matthewgream/12vdc_ups_18650_4s5p/README.md

# 12 VDC UPS — 18650 4S5P

A compact DC uninterruptible power supply that delivers a regulated **12 V** to network equipment (fibre CPE, router, Wi-Fi hub) from a 24 V mains adapter, with seamless switchover to a **4S5P 18650 lithium-ion pack** when mains fails.

It's built around an off-the-shelf DC UPS module that does the charging, power-path switching, buck-boost regulation and battery undervoltage cutoff. Around it sit a balancing BMS, per-output fusing, and a 3D-printed PETG housing and cell harness (OpenSCAD sources included).

> ⚠️ **Lithium-ion packs store a lot of energy (~250 Wh here) and can cause fires if built or used incorrectly.** This is a record of one build, not a certified product. Build at your own risk, and only if you are comfortable with spot-welding cells, pack wiring and DC fusing.

| Assembly | Plan |
|---|---|
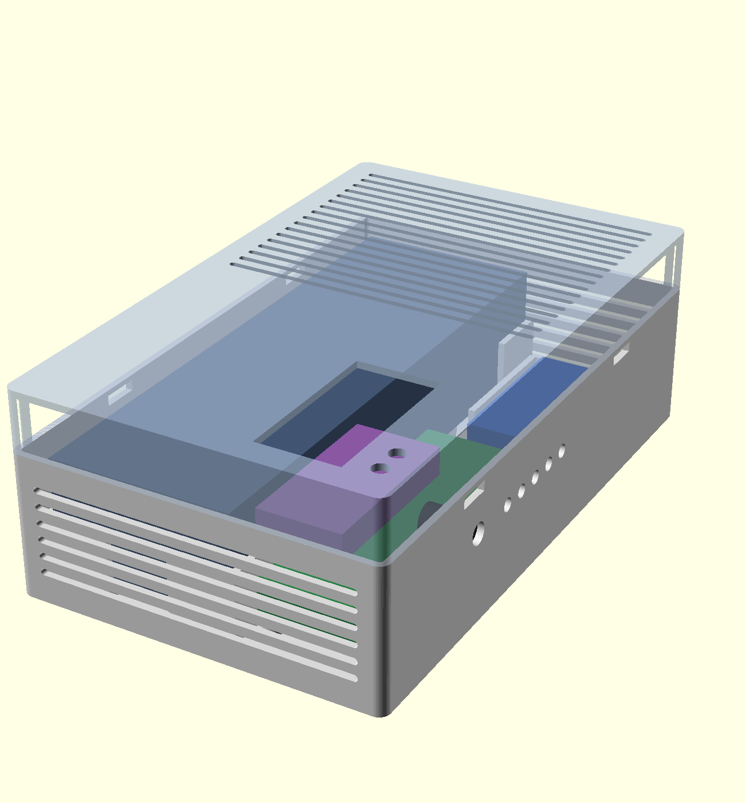
[picture p1: housing_ups_12vdc_assembly.png]
Assembly view
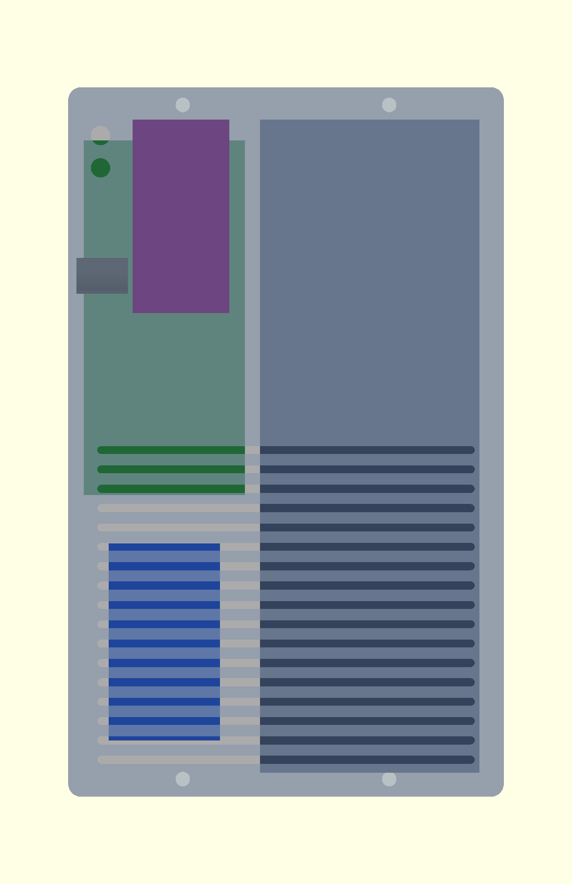
[picture p2: housing_ups_12vdc_plan.png]
Plan view
|  |  |

_Renders of the housing design. See [Build photos](#build-photos) for the real thing._

---

## Contents

- [Overview](#overview)
- [Specifications and operating limits](#specifications-and-operating-limits)
- [Runtime](#runtime)
- [Architecture](#architecture)
- [Bill of materials](#bill-of-materials)
- [Housing and harness (3D files)](#housing-and-harness-3d-files)
- [Build](#build)
- [Board configuration](#board-configuration)
- [Commissioning and testing](#commissioning-and-testing)
- [Operation and maintenance](#operation-and-maintenance)
- [Safety notes](#safety-notes)
- [Build photos](#build-photos)
- [Design rationale](#design-rationale)

---

## Overview

| | |
|---|---|
| Output | 12.0 V DC regulated, 5 individually fused outputs (2 A, 2 A, 3 A, 3 A, 5 A; 5.5 mm barrel) |
| Input | 24 V DC, 5 A (120 W) external adapter |
| Battery | 20 × 18650 Li-ion, 4S5P, ~14.5 V nominal, ~17.5 Ah, ~254 Wh |
| Switchover | Zero-time; output stays regulated across mains loss and return |
| Protection | Board UVP + output OCP/short protection, Daly 4S BMS (per-cell OV/UV/OC/short + balancing), fused battery, input and outputs |
| Intended load | ~20–30 W of network equipment (e.g. CTS HES-3106-PLUS, MikroTik PowerBox Pro, Sagemcom Wi-Fi Hub 2) |

### Why 4S?

A 3S Li-ion pack spans 9.0–12.6 V and sits at ~11.1 V for most of its discharge, which is below 12 V. 4S spans 12.0–16.8 V. The UPS module's buck-boost regulator could run from either, but 4S halves the battery current for a given load compared with 2S, cuts it by about a quarter compared with 3S, and keeps the converter working in step-down mode for nearly the whole discharge. That means lower losses and less heat.

---

## Specifications and operating limits

### UPS module (as supplied)

| Parameter | Limit |
|---|---|
| Input voltage | 10–28 V DC; must be ≥ 1 V above the charge voltage to charge |
| Input current | 15 A max (fuse-limited) |
| Output voltage | 2–28 V adjustable, **set to 12.0 V** |
| Output current | 8.3 A continuous (100 W), 10 A peak |
| Output regulation / ripple | ±2%, < 80 mV p-p |
| Charge voltage | 4–23 V adjustable |
| Charge current | 0.5–5 A adjustable; terminates at 1/10 of set current |
| Efficiency | > 95% (charging and output conversion) |
| Standby current | < 200 µA |
| Operating temperature | −45 to +85 °C (board) |

### System limits (this build)

These come from the weakest component in each path, not from the module alone.

| Parameter | Limit | Set by |
|---|---|---|
| Output, on battery | **≤ 100 W continuous** (8.3 A) | UPS module |
| Output, on mains, while charging | **≤ ~75 W continuous** | 24 V 5 A adapter (120 W) minus ~34 W charging |
| Output, on mains, battery full | **≤ 100 W** | UPS module (the 120 W adapter is no longer the limit) |
| Per-output current | Fuse rating: 2 / 2 / 3 / 3 / 5 A | Output fuses (F2–F6) |
| **Total output, all outputs combined** | **≤ 8.3 A continuous (100 W), 10 A peak** | UPS module. The output fuses add up to 15 A, so they are deliberately over-provisioned. Each fuse protects only its own branch, and the combined load must stay within the module rating (and within the adapter budget on mains). |
| Battery discharge current | ~8.5 A at 100 W out and 12.4 V cutoff (~1.7 A/cell) | Load; pack fuse 10 A, BMS 15 A, cells 10 A each |
| Battery charge current | **2.0 A** (~0.11C, 0.4 A/cell) | Setting (VR1) |
| Charge voltage (charge ceiling) | **16.2 V** (4.05 V/cell, ~85% SoC); selectable 16.0–16.8 V | Setting (VR2), see [Charge ceiling](#charge-ceiling-state-of-charge) |
| Undervoltage cutoff | **12.4 V** (3.10 V/cell) | Setting (VR4) |
| Restart threshold | **13.6 V** (3.40 V/cell) | Setting (VR3) |
| Cell charge temperature | 0–45 °C | Li-ion chemistry; **do not charge below 0 °C** |
| Cell discharge temperature | −20 to +60 °C | Li-ion chemistry |
| Enclosure ambient | Indoor, dry, ideally 10–30 °C | Housing material and cell life |

> **Note on the adapter:** the module doesn't appear to throttle charge current to protect the adapter. The **24 V 5 A (120 W)** adapter supports ~75 W of output while charging; for heavier loads, reduce the charge current or fit a larger adapter.

> **Note on "10 A":** the module's continuous rating is **8.3 A at 12 V**, with 10 A as a peak. Size loads accordingly.

---

## Runtime

At the default 85% charge ceiling, usable energy is about **195 Wh** at the output. That's 254 Wh nominal, less ~15% unused at the top, a few percent below the 3.10 V/cell cutoff, and ~5% conversion loss. For other ceilings see [Charge ceiling](#charge-ceiling-state-of-charge).

| Load | Approx. runtime (85% ceiling) |
|---|---|
| 10 W | ~19 h |
| 20 W | ~10 h |
| 25 W | ~8 h |
| 30 W | ~6.5 h |
| 50 W | ~4 h |
| 100 W | ~2 h |

Real-world draw of network gear is usually well below adapter ratings. Measure yours with an inline DC meter.

---

## Architecture

```
 230 VAC ──► 24 V 5 A PSU ──► panel jack ──► [F1 7.5 A, inline] ──► UPS VIN+ / GND
                                                           │
                                                    ┌──────┴───────┐
                                                    │  UPS module  │  charge (CC/CV, buck)
                                                    │              │  power path (zero-time)
  4S5P pack ─► [F0 10 A, inline] ─► Anderson ─► BAT │              │  buck-boost 12.0 V out
     │                          ▲                   │              │  UVP / restart
     └─ Daly 4S BMS (B-/P-, balance leads)          └──────┬───────┘
                                                           │ VOUT 12 V / GND
                                                           ▼
            VOUT+ ─► 5.08 mm edge conn (+, fan-out) ─┬─► [F2 2 A] ─► OUT1
                                                     ├─► [F3 2 A] ─► OUT2
                                                     ├─► [F4 3 A] ─► OUT3
                                                     ├─► [F5 3 A] ─► OUT4
                                                     └─► [F6 5 A] ─► OUT5
            GND ───► 5.08 mm edge conn (−, fan-out) ───────────────► OUT1…OUT5 sleeves

            All fuses F0–F6 are inline blade holders inside the housing.
```

- **F0 (pack fuse)** is an inline holder inside the housing, on the pack positive between the BMS/pack side and the Anderson connector. Keeping it on the pack side means it protects the Anderson, the leads to the board and the board's battery input from a pack-fed short. The only unprotected conductor is the short lead from the pack to F0, so keep it as short as practical and well secured.
- The **BMS** switches the pack negative (B- to cells, P- to the Anderson). It is a **common-port** type: charge and discharge share P-.
- The **Anderson connector** is the battery service disconnect. Open it whenever you adjust charge voltage or work on the board.
- **Inline fusing throughout:** every fuse (F0 pack, F1 input, F2–F6 outputs) is an inline blade holder inside the housing. That's neater and more compact than a fuse block, and no routine user servicing is expected. Separate holders also mean the 24 V input and the 12 V outputs can never share a bus.
- **Outputs are a menu, not a budget:** the five outputs are fused 2 / 2 / 3 / 3 / 5 A so each device can be plugged into a suitably rated output. The fuses total 15 A, which is more than the module's 8.3 A. The combined load is limited by the module and the adapter, not by the fuses (see [System limits](#system-limits-this-build)).

---

## Bill of materials

Prices are as purchased (GBP, late 2026) and are indicative only. Choose 5.5/2.1mm or 5.5/2.5mm barrel fittings as appropriate. I purchased an equal set of both, and the 24 V power supply turned out to have 2.1mm male, so the 2.1mm variant of the panel connector was installed. Other options are to dual 5.5/2.1+2.5 on each output, or to select 2.1 or 2.5 but arm with 2.1->2.5 or 2.5->2.1 adapters.

| Qty | Item | Price (ea.) | Notes | Link |
|---|---|---|---|---|
| 1 | DC power supply 24 V 5 A, 5.5/2.x barrel | £13.94 | Mains input. Must be ≥ 1 V above the charge voltage (≥ 17.8 V covers every ceiling up to 16.8 V). 5 A (120 W) covers ~75 W of load while charging. | [AliExpress](https://www.aliexpress.com/item/1005007332397741.html) |
| 1 | DC UPS power module, 12 V out, 15 A max input | £36.79 | Main board: charger, power path, buck-boost regulator, UVP, LEDs | [AliExpress](https://www.aliexpress.com/item/1005001636977344.html) |
| 1 | Daly 4S 15 A BMS, 3.7 V Li-ion, common port, with balancing | £7.15 | Per-cell protection and passive balancing | [AliExpress](https://www.aliexpress.com/item/1005005995685641.html) |
| 1 | Inline blade fuse holder, 16 AWG, 10 A (2-pack) | — | Used for F0 (pack, 10 A fuse) and one output. With the 5-pack below this gives 7 holders: 6 × 16 AWG (F0, F2–F6) and 1 × 12 AWG (F1). | [Amazon](https://www.amazon.co.uk/dp/B0HG927H6S) |
| 1 | Inline blade fuse holder set (5 pcs): 1 × 12 AWG 15–30 A, 4 × 16 AWG 10 A | — | 12 AWG holder for F1 (24 V input, 7.5 A fuse). 4 × 16 AWG holders for outputs. | [Amazon](https://www.amazon.co.uk/dp/B0DBPQBGBQ) |
| n | DC blade fuses 2/3/5/7.5/10 A | £0.93 | F0 10 A, F1 7.5 A, F2–F6 2/2/3/3/5 A. Name-brand with 1000 A DC interrupt rating recommended for F0. | [AliExpress](https://www.aliexpress.com/item/4000832079230.html) |
| 1 | DC 5.5/2.x barrel panel connector, 10 A, 15 cm | £1.37 | Mains adapter input jack | [AliExpress](https://www.aliexpress.com/item/1005007189485497.html) |
| 5 | DC 5.5/2.x power leads, 18 AWG, 1.5 m | £3.26 | One per output. Match inner diameter (2.1 or 2.5 mm) to each device. 18 AWG is good to ~7 A. | [AliExpress](https://www.aliexpress.com/item/1005012145395888.html) |
| 1 | DC voltage level display (panel meter) | £4.69 | Front-panel battery voltage readout; fits the 60 × 30 mm window in the cover. Its measuring and supply range must cover the pack (12–16.8 V). See [Wiring](#6-wiring) for where to connect it. | [AliExpress](https://www.aliexpress.com/item/1005006408211879.html) |
| 2 | 6 mm LED indicator, panel mount, 3–6 V | £0.78 | Front-panel status LEDs via J8 (e.g. input power, charging/fault), mounted in the cover beside the meter. 5-pack (£3.89). | [AliExpress](https://www.aliexpress.com/item/1005005391948256.html) |
| 20 | LG MJ1 18650, 3500 mAh, 10 A | £2.81 | 4S5P, welded in a 10 × 2 honeycomb array | [Cell Supply](https://www.cellsupply.co.uk/lg-mj1-18650-battery) |
| 1 | 2-core 18 AWG silicone tinned copper wire | £1.60 | Internal hookup | [AliExpress](https://www.aliexpress.com/item/1005012526819544.html) |
| 1 | Anderson 30 A connector | £2.51 | Pack-to-board connection and safety disconnect | [AliExpress](https://www.aliexpress.com/item/1005006226687227.html) |
| 2 | 5-pin pluggable edge connector, 5.08 mm, 15 A | £0.88 | 1 × UPS VOUT− fan-out to 5 outputs; 1 × UPS VOUT+ fan-out to the 5 output fuses | [AliExpress](https://www.aliexpress.com/item/1005009224192771.html) |
| 1 | 3-pin 2.54 mm JST connector, PCB + lead | — | Detachable LED harness | — |
| — | Nickel strip, 10 mm × 0.15 mm | — | Cell interconnects and wire tabs | — |
| — | Spot welder | — | — | — |
| 20 | Fish-paper insulator rings, 18650 | — | One per cell positive terminal | — |
| — | Heat-resistant insulating tape, packaging | — | Pack wrap | — |
| 4 | M4 self-tapping screws | — | UPS module to base | — |
| 4 | M4 self-tapping screws | — | Wall mounting | — |
| 1 | 3D-printed housing (base + cover), PETG | — | See below | — |
| 1 + 2 | 3D-printed cell harness: 1 footer + 2 spacers, PETG | — | See below | — |

**Approximate total:** ~£150 plus fuse holders (parts listed with prices, excluding printing, tools and consumables).

---

## Housing and harness (3D files)

| File | Description |
|---|---|
| `housing_ups_12vdc.3mf` | Print project for the enclosure and harness (Bambu Studio) |
| `housing_ups_12vdc.scad` | (Source) Parametric OpenSCAD source for the enclosure |
| `housing_ups_12vdc_base.stl` | (Generated) Enclosure base: UPS module, BMS, battery pack, wiring  |
| `housing_ups_12vdc_cover.stl` | (Generated) Enclosure cover |
| `housing_ups_12vdc_assembly.png` | (Generated) Assembly render |
| `housing_ups_12vdc_plan.png` | (Generated) Top-down plan render |
| `harness_cell_pack_18650.scad` | (Source) Parametric OpenSCAD source for the harness |
| `harness_cell_pack_18650_footer.stl` | (Generated) Cell footer: welding jig |
| `harness_cell_pack_18650_spacer.stl` | (Generated) Cell spacer: structural |
| `Makefile` | Build targets for the generated files |
| `images/` | Build photos |

**Cell harness.** The honeycomb cells don't butt against each other, so the welded nickel shouldn't be the only thing holding the pack in shape.
- **Footer:** the cells stand in it during welding, which holds them square and level so the strips sit flat across all ends.
- **Spacers (×2):** slid over the cells, one about 10 mm from the top and one about 10 mm from the bottom. They fix cell spacing and make the pack rigid independently of the welds, so handling and mounting loads aren't taken through the weld nuggets.

**Material:** all parts are printed in **PETG**. PLA softens at ~55–60 °C, and the enclosure sits next to a pack and a converter for years. No common printed plastic is fire-rated. Consider where the unit is mounted (see [Safety notes](#safety-notes)).

---

## Build

### 1. Cells
- Buy all cells from a reputable supplier in one batch. Counterfeit cells are common.
- Check each cell's voltage on arrival. Group cells so each parallel group is within **~0.05 V**, and preferably match groups by capacity.
- Fit fish-paper insulator rings on positive terminals. The positive cap and the can (negative) are millimetres apart.

### 2. Pack (4S5P)
- Stand the 20 cells in the **footer** as a 10 × 2 honeycomb, forming four parallel groups of five, and fit the two **spacers** (~10 mm from each end).
- Spot-weld 0.15 mm nickel. Don't solder directly to cells.
- Main leads: crimp 18 AWG to nickel tabs, then weld the tabs to the pack ends.
- Balance leads: weld to B0 (pack −), B1, B2, B3 and B4 (pack +). **Before covering,** measure B0→B1, B1→B2 and so on in sequence. Each step must read one group's voltage (~3.6–3.7 V as received), and B0→B4 the full pack voltage.
- Strain-relieve all leads so they can't flex at the weld.
- Wrap in heat-resistant tape, leaving the balance connector, F0 holder and Anderson connector outside the wrap and accessible.

### 3. BMS (Daly 4S, common port)
- Cells' negative → **B-**. BMS **P-** → Anderson negative.
- Follow Daly's connection order: B- first, then check balance lead voltages with a multimeter, then plug in the balance connector last. Wrong balance lead order is the most common way to destroy a BMS.
- Some Daly boards hold P- off until a charger voltage is applied. If you read 0 V at P-, connect the 24 V adapter once to wake it.

### 4. Pack fuse and disconnect
- **F0: 10 A blade fuse** in an inline holder mounted inside the housing, wired from the pack positive to the Anderson positive. The fuse is on the pack side of the disconnect, so it protects the Anderson and everything downstream.
- Keep the pack → F0 lead short and secured. It's the only conductor upstream of the fuse.
- Use a name-brand DC blade fuse. Voltage rating ≥ 24 V DC (pack max is 16.8 V), and interrupt rating ~1000 A DC.

### 5. Fusing
All fuses are inline blade holders inside the housing.

| Fuse | Circuit | Fuse rating | Holder |
|---|---|---|---|
| F0 | Pack positive → Anderson | 10 A | 16 AWG, 10 A |
| F1 | 24 V input: panel jack → UPS Vin+ | 7.5 A (suits the 5 A adapter) | 12 AWG, 15–30 A |
| F2 | OUT1 | 2 A | 16 AWG, 10 A |
| F3 | OUT2 | 2 A | 16 AWG, 10 A |
| F4 | OUT3 | 3 A | 16 AWG, 10 A |
| F5 | OUT4 | 3 A | 16 AWG, 10 A |
| F6 | OUT5 | 5 A | 16 AWG, 10 A |

The outputs are a choice of ratings: plug each device into an output whose fuse is roughly 1.5–2× its normal draw and no more than its original adapter rating. The output fuses total 15 A, but **the combined load must stay within 8.3 A continuous** (the module limit), and within ~75 W on mains while charging (the adapter limit). Keep peak loads in mind when adding devices.

Example allocation (this installation):

| Output | Fuse | Device |
|---|---|---|
| OUT1 | 2 A | CTS HES-3106-PLUS (12 V 1.5 A adapter) |
| OUT2 | 2 A | Spare |
| OUT3 | 3 A | Sagemcom Wi-Fi Hub 2 |
| OUT4 | 3 A | MikroTik PowerBox Pro |
| OUT5 | 5 A | Spare |

> **MikroTik PowerBox PoE-out:** the PowerBox's PoE-out ports (ether2–5) pass through whatever voltage the PowerBox is running from. In this installation one PoE-out port feeds an annex Wi-Fi AP. That AP is non-essential and is **not budgeted on the UPS**; it's allowed to drop during an outage, because the primary AP (Sagemcom) stays up. Check what actually happens to it when the PowerBox runs from the UPS's 12 V. An AP that accepts 12 V passive PoE would keep running and draw from the UPS (and through the 3 A fuse). One that needs 24 V+ will drop out or reboot-loop. If it does keep running, either budget for it or disable PoE-out on that port during outages (e.g. a RouterOS script on the PowerBox's voltage monitor).

### 6. Wiring
- 18 AWG silicone for internal hookup. The fuse holders' own 16 / 12 AWG pigtails are fine to join to it. Battery-side current is ≤ ~3 A normally and ≤ ~8.5 A worst case.
- Adapter jack → F1 → UPS **Vin+**. Jack negative → UPS input **GND**.
- UPS **VOUT+** → positive edge connector (fan-out) → F2–F6 → barrel centre pins.
- UPS output **GND** → negative edge connector (fan-out) → barrel sleeves.
- Pack (via F0 and Anderson) → UPS **BAT** terminals (J1).
- LEDs → J8 via the 3-pin JST lead (J8 carries LED1–LED3).
- Panel meter → UPS **BAT** terminals (J1), i.e. downstream of F0 and the Anderson, so its leads are fused and opening the Anderson disconnects it. Use a 2-wire meter there, or for a 3-wire meter take both its supply and its sense lead from BAT.
- **The meter is a permanent load on the pack** (typically 5–20 mA), including after the module's undervoltage cutoff has turned the output off. On a very long outage it keeps discharging the pack below 12.4 V until the BMS's own undervoltage trip disconnects it. That's safe, because the BMS is the backstop, but the pack then needs mains back to wake the BMS. If you'd rather avoid this, take the meter's supply from the 12 V output instead, so it switches off with the UVP, and keep only its sense lead on BAT (3-wire meters only).

### 7. Jumpers
- **J5 closed** (start switch) and **J7 shorted** (auto-start). Together these make the module start automatically whenever input power returns or the battery recovers above VSTART. Unattended operation needs this.
- **J6** left unset (mode 0). It's only used when the load is a PC motherboard.

---

## Board configuration

| Setting | Target | Adjust | How |
|---|---|---|---|
| Charge voltage | **16.2 V** (4.05 V/cell, ~85%); see table below | VR2 | **Battery disconnected.** Measure at the BAT terminals. The output pulses while detecting a battery; set the *peak* to the target. Counterclockwise raises. |
| Charge current | **2.0 A** | VR1 | Battery connected and partly discharged, ammeter in series with BAT+. Counterclockwise raises. |
| Undervoltage cutoff (VUVP) | **12.4 V** | VR4 | VUVP = 4 × V(TP4) → TP4 = **3.10 V** |
| Restart threshold (VSTART) | **13.6 V** | VR3 | VSTART = 4 × V(TP3) → TP3 = **3.40 V** |
| Output voltage | **12.0 V** | VR5 | J5 closed, no loads connected, measure at output |

Factory defaults are for 3S (12.6 V charge, 1 A, 9.0 V UVP, 9.6 V start, 12 V output). **Never connect a 4S pack before raising the charge voltage**, or it will charge incorrectly. And never adjust the charge voltage with any battery connected.

### Charge ceiling (state of charge)

A UPS pack spends almost all its life sitting at its charge ceiling, so **calendar ageing at high state of charge, not cycling, is what wears it out.** Lowering the ceiling is the single most effective way to extend pack life. The module terminates charging at C/10 and does not float, so the pack charges to the ceiling and then rests there.

| Ceiling (approx. SoC) | Per cell | Pack (set VR2) | Usable at output | Runtime @ 25 W | Longevity |
|---|---|---|---|---|---|
| 100% | 4.20 V | 16.8 V | ~230 Wh | ~9 h | Shortest. Only for a periodic top-balance. |
| 95% | 4.15 V | 16.6 V | ~220 Wh | ~8.5 h | Modest gain |
| 90% | 4.10 V | 16.4 V | ~205 Wh | ~8 h | Good |
| **85% (default)** | **4.05 V** | **16.2 V** | **~195 Wh** | **~8 h** | **Very good** |
| 80% | 4.00 V | 16.0 V | ~180 Wh | ~7 h | Best of these |

SoC figures are approximate for LG MJ1. They depend on chemistry, temperature and where termination occurs, so treat them as ±5%.

**Recommendation: 80–90%, default 85%.** This matches common practice in consumer devices: phones and laptops typically offer an 80–85% "battery protection" limit for devices left on charge. Below ~80% you give up runtime for diminishing longevity gain. Pick the lowest ceiling that still gives the runtime you need.

> **Balancing at reduced ceilings:** passive balancers on many BMS boards only bleed cells near the top of charge. Check the balance start voltage on your Daly BMS (label or listing). If it's above your ceiling, the BMS will never balance. Check group voltages every 6–12 months. If they've drifted by more than ~0.03 V, do one top-balance: disconnect the battery, set VR2 to 16.8 V, reconnect, let it charge and rest a day, then set it back. Alternatively, balance with a hobby charger on the balance lead.

### Why these values
- **Charge ceiling 16.2 V (85%):** see above. Longevity is the priority for an always-on UPS.
- **2.0 A:** gentle (0.4 A per cell, ~0.11C). Recharge time isn't critical. A full recharge from cutoff takes ~8–9 h, and total adapter load stays well within 120 W.
- **12.4 V cutoff:** well above the BMS's own over-discharge trip, so the BMS is a backstop rather than the normal cutoff. Also little capacity is left below ~3.1 V/cell under load.
- **13.6 V restart:** enough hysteresis that a rested pack recovering after cutoff doesn't make the output cycle on and off.

---

## Commissioning and testing

1. **Pre-power checks:** pack, BMS and balance leads verified (Build steps 2–3). Confirm with a continuity tester that there's no path from the 24 V input (jack, F1, Vin+) to the 12 V outputs, and that each output's fuse is in its positive lead. Anderson open. No loads connected.
2. **Adapter only:** connect the 24 V adapter. LED1 (blue, input) lights.
3. **Set the charge voltage** (VR2) to the chosen ceiling (default 16.2 V) as the peak at the BAT terminals.
4. **Set the thresholds:** TP4 = 3.10 V (VR4), TP3 = 3.40 V (VR3).
5. **Set the output:** J5 closed, J7 shorted. Set VOUT to 12.0 V (VR5). LED4 (output) lights.
6. **Connect the battery:** close the Anderson. Wake the BMS if needed. Charging starts; LED3 (green) lights.
7. **Set the charge current** (VR1) to 2.0 A with an ammeter in series. Do this with the pack partly discharged, or the reading won't be accurate.
8. **Switchover test:** connect a dummy or real load. Pull the adapter. VOUT must stay at 12.0 V with no reset of connected equipment. Restore the adapter and confirm charging resumes.
9. **Full charge:** confirm termination (LED3 off, LED2 red on) at the ceiling voltage, with current tapering to ~0.2 A.
10. **Recharge behaviour:** after termination, run briefly on battery (pull the adapter for a few minutes under load), then restore it. Confirm charging restarts. The manual doesn't document the recharge threshold, so verify the pack is topped up after short outages and not only after long ones.
11. **Runtime / UVP test (recommended once):** run on battery under normal load until cutoff. Confirm the output switches off near 12.4 V pack voltage and the BMS has *not* tripped. Restore mains and confirm auto-restart and recharge.
12. **Balance check:** after a full charge, measure each group. They should be within ~0.02 V.

---

## Operation and maintenance

- **Panel meter:** shows pack voltage. Use the [charge ceiling table](#charge-ceiling-state-of-charge) for full (16.0–16.8 V depending on setting) and 12.4 V for empty (UVP cutoff). Readings while charging or under load are a few tenths of a volt off the resting value.
- **Indicators:** LED1 blue = input present. LED3 green = charging; flashes when the battery is below VSTART, or flashes twice when it's below VUVP at start-up. LED2 red = charge complete. LED4 red = output on.
- **After an outage,** the module recharges automatically. A full recharge from cutoff takes ~8–9 h at 2.0 A.
- **Every 6–12 months:**
  - Check group balance (pack within ~0.02 V). Top-balance if needed (see [Charge ceiling](#charge-ceiling-state-of-charge)).
  - Check the enclosure for heat discolouration and the connectors for looseness.
  - Do a short discharge test to confirm runtime hasn't fallen significantly.
- **Storage:** if the unit will be unpowered for weeks, store the pack at ~3.7–3.8 V/cell (~15 V) and open the Anderson to remove BMS and board standby drain.
- **Retirement:** replace the pack if runtime drops below ~70% of new, or if any group drifts persistently out of balance.

---

## Safety notes

- **Fusing:** every source is fused: pack (F0, 10 A, inline), adapter input (F1, 7.5 A, inline), each output (F2–F6, 2/2/3/3/5 A), all inline inside the housing. The pack fuse is the critical one. A 254 Wh pack can source hundreds of amps into a short.
- **Disconnect** the battery (Anderson) before any work on the board, wiring or settings.
- **Never charge below 0 °C.** Lithium plating causes permanent damage and internal shorts. Don't install in unheated outbuildings or lofts without accounting for this.
- **Location:** mount on a non-combustible surface, away from soft furnishings, with airflow around the enclosure. A printed enclosure provides no fire containment.
- **Cell abuse:** don't mix cells of different type, age or state of charge. Discard any cell that is dented, has torn wrap, or self-discharges noticeably.
- **Polarity:** the module isn't documented as reverse-polarity protected on the battery input. Check polarity before closing the Anderson.

---

## Build photos

### Initial bench test - battery/mains supply/charge cycles

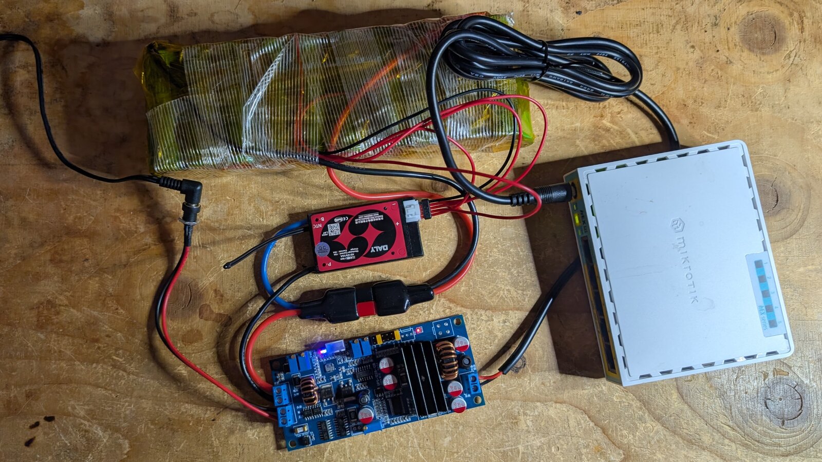
[picture p3: images/housing_ups_12vdc_bench_test_1.jpg]
Bench test of the UPS module, pack and wiring before assembly


_Bench test before assembly._ Tests run:
- Configure all parameters and check voltages and currents.
- Output stays up on the 24 V adapter and when the adapter is unplugged (battery).
- Discharge on battery past the restart threshold, then restore the adapter and monitor charging through to termination. Measure the charged pack voltage.
- Repeat with the pack drained down to the undervoltage cutoff.

### Assembly bench test

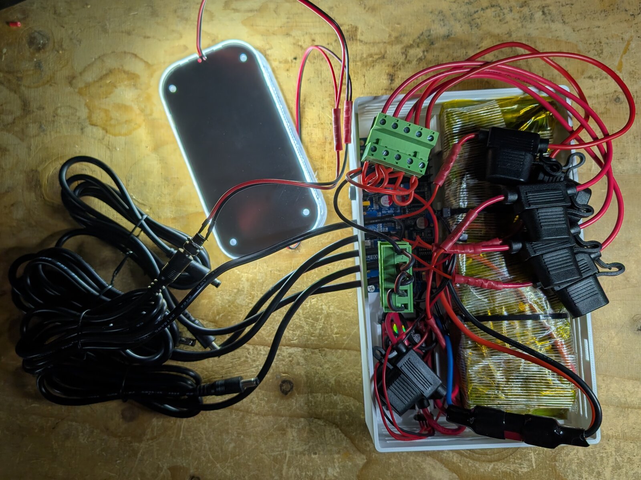
[picture p4: images/housing_ups_12vdc_bench_test_2.jpg]
Bench test of the UPS module, pack and wiring during assembly


_Bench test during assembly._ Tests run:
- Verify power and polarity on all wiring paths.
- Check assembly fitting (identified that the choice of inline fuse holders requires bulking out the cover).

### Built

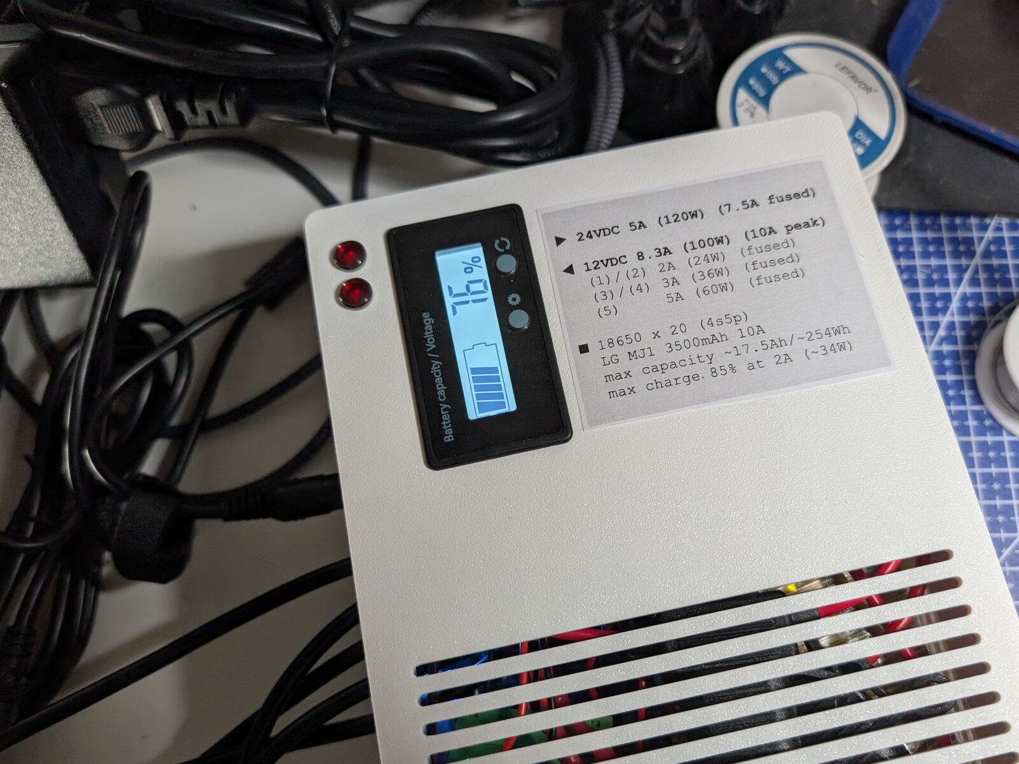
[picture p5: images/housing_ups_12vdc_built.jpg]
Built version, with battery monitor installed


_Build complete, with <a href="https://docs.google.com/document/d/1GiLOf5nCyJNSllKJYwVlJ6xkPohoDqQ-DGhpVirwHKc/view">label</a>_

---

## Design rationale

- **Integrated UPS module vs separate charger + buck:** an earlier candidate module (UPS-0528-11) passes the input voltage straight through to the output on mains (24 V) and outputs unregulated battery voltage on outage. It would have needed a separate wide-input buck converter and a low-voltage disconnect. The chosen module integrates a 100 W buck-boost regulator and adjustable UVP with restart hysteresis.
- **4S over 3S:** lower battery current and a near-continuous buck-mode regulator. 3S would also work with the module's factory settings at this load.
- **5P:** ~8 h runtime for ~25 W of network equipment, with each cell working at < 0.5 A typical.
- **Separate BMS:** the module only monitors total pack voltage. The Daly BMS adds per-cell over- and undervoltage protection, short-circuit protection and balancing.
- **Reduced charge ceiling and current:** an always-on UPS is limited by calendar ageing at high state of charge, and recharge time is rarely critical. So both are set for longevity rather than maximum runtime or fast recharge.
- **24 V adapter:** gives the 1 V headroom the step-down charger needs above any charge ceiling up to 16.8 V. A 19 V adapter would also work and slightly reduce charger conversion loss, but 24 V 5 A units are more common.

---

## Licence

See [`LICENSE`](LICENSE).
