matthewgream/12vdc_ups_18650_4s5p/label.pdf

- 24VDC 5A (120W) (7.5A fused)

◀ 12VDC 8.3A (100W) (10A peak) ◀ (1)/(2) 2A (24W) (fused)
◀ (3)/(4) 3A (36W) (fused)
◀ (5) 5A (60W) (fused)

■ 18650 x 20 (4s5p)
■ LG MJ1 3500mAh 10A
■ max capacity ~17.5Ah/~254Wh ■ max charge 85% at 2A (~34W)
