matthewgream/12vdc_ups_18650_4s5p/housing_ups_12vdc.3mf

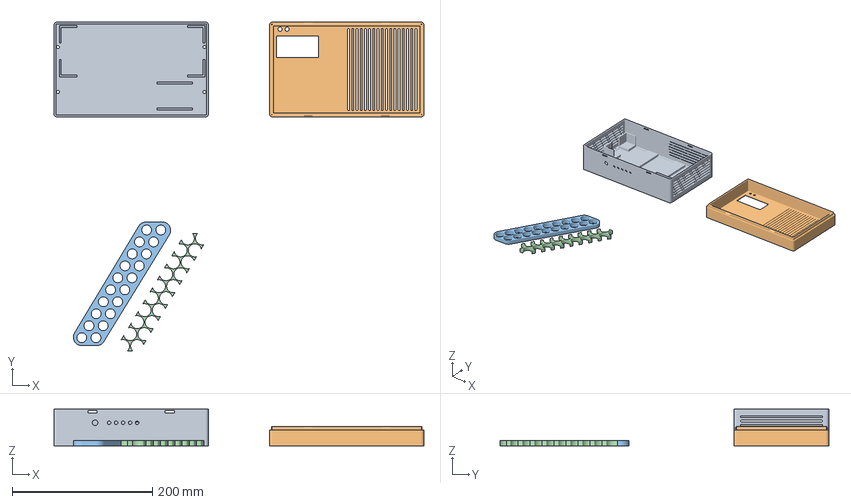
[picture p6: CAD file, 2026-11-06]
housing_ups_12vdc.3mf
527.2 x 468.3 x 52.5 mm
housing_ups_12vdc_base.stl
housing_ups_12vdc_cover.stl
18650-cell-pack-harness_footer.stl
18650-cell-pack-harness_spacer.stl
