matthewgream/12vdc_ups_18650_4s5p/housing_ups_12vdc_base.stl

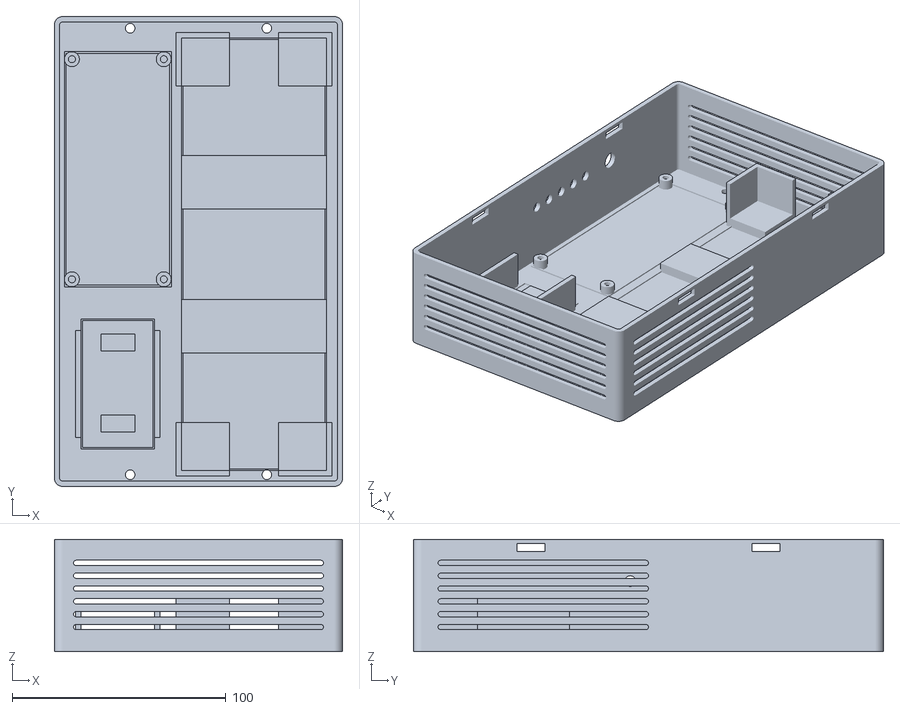
[picture p7: CAD file, 2026-11-06]
housing_ups_12vdc_base.stl
135.0 x 220.0 x 52.5
