matthewgream/12vdc_ups_18650_4s5p/housing_ups_12vdc_cover.stl

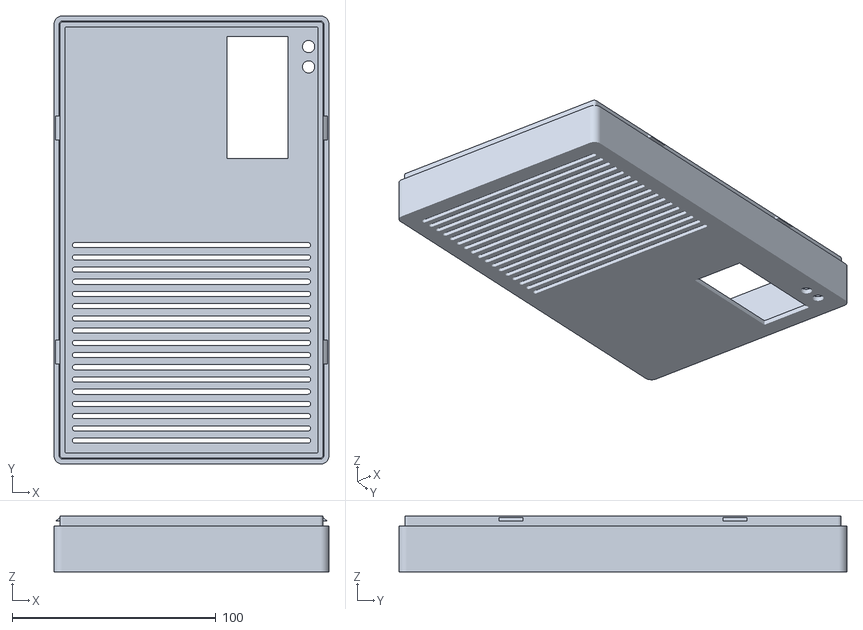
[picture p8: CAD file, 2026-11-06]
housing_ups_12vdc_cover.stl
135.0 x 220.0 x 27.5
