matthewgream/12vdc_ups_18650_4s5p/harness_cell_pack_18650_spacer.stl

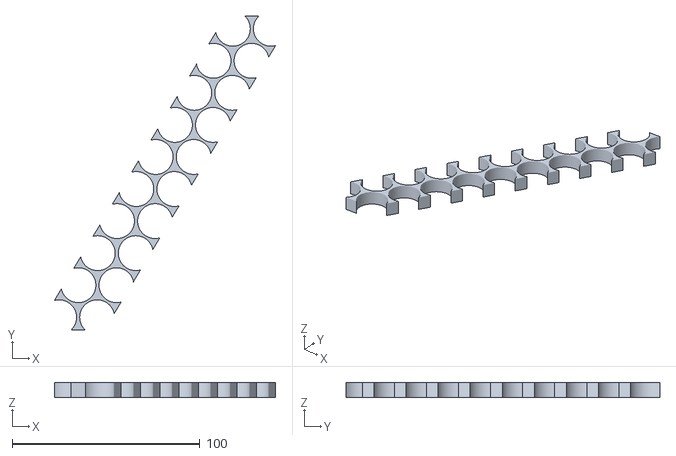
[picture p9: CAD file, 2026-11-03]
harness_cell_pack_18650_spacer.stl
117.7 x 167.1 x 8.00
