matthewgream/12vdc_ups_18650_4s5p/harness_cell_pack_18650_footer.stl

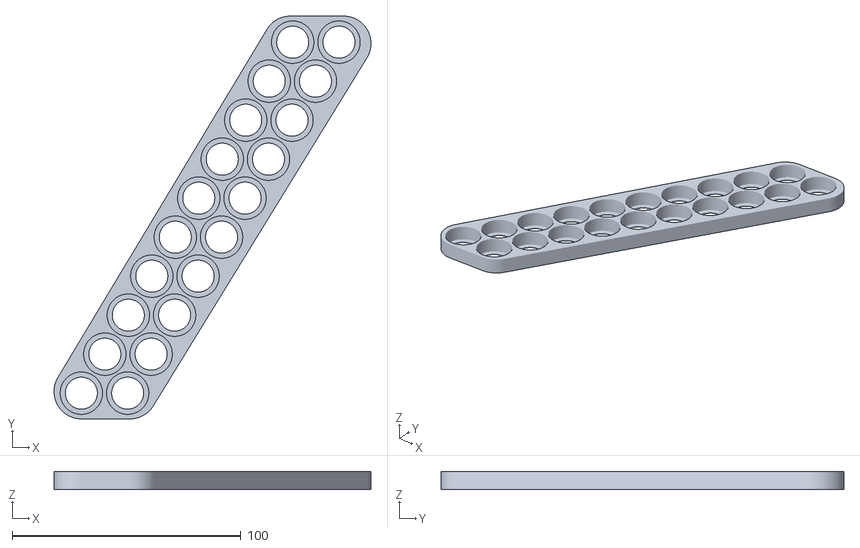
[picture p10: CAD file, 2026-11-03]
harness_cell_pack_18650_footer.stl
138.6 x 176.2 x 8.00
