matthewgream/12vdc_ups_18650_4s5p/(list of files, cad)

Other CAD files:
18650-cell-pack-harness_footer.stl
18650-cell-pack-harness_spacer.stl
harness_cell_pack_18650.scad
