matthewgream/12vdc_ups_18650_4s5p/(commit log)

2026-11-02 remove fuse holder block to replace with inline fuses
    [housing_ups_12vdc.3mf, housing_ups_12vdc.scad, housing_ups_12vdc_base.stl, housing_ups_12vdc_cover.stl]
2026-11-02 fix hole placeement
    [housing_ups_12vdc.3mf, housing_ups_12vdc.scad, housing_ups_12vdc_base.stl, housing_ups_12vdc_cover.stl]
2026-11-03 screw holes move
    [housing_ups_12vdc.3mf, housing_ups_12vdc.scad, housing_ups_12vdc_base.stl, housing_ups_12vdc_cover.stl]
2026-11-03 renaming, formatting
    [harness_cell_pack_18650.scad, harness_cell_pack_18650_footer.stl, harness_cell_pack_18650_spacer.stl, housing_ups_12vdc.scad, housing_ups_12vdc_base.stl, housing_ups_12vdc_cover.stl]
2026-11-04 pad thai + others
    [housing_ups_12vdc.3mf, housing_ups_12vdc.scad, housing_ups_12vdc_base.stl, housing_ups_12vdc_cover.stl]
2026-11-05 add cover walls
    [housing_ups_12vdc.3mf, housing_ups_12vdc.scad, housing_ups_12vdc_base.stl, housing_ups_12vdc_cover.stl]
